maccasoft/propeller-vt100-terminal/(threads)

Thread 1 (2018-12-05):

full 9x16 support now available

konimaru, 2018-12-05:
Just to let you know that there is now a new version available which uses a real 9x16 font (liberated from some FON file). The colour blink attribute is currently MIA but can be brought back if necessary.

maccasoft, 2018-12-20:
Thank you, I have implemented the "nine" driver and I think I'm happy with it, even if it uses a bit more memory.

Happy holidays!

Closed 2018-12-20.

Thread 2 (2019-03-21):

question on build

huskeyw, 2019-03-21:
I built the code changing the pins for the usb keyboard and serial to match the hobytronics board.. I was hoping I could turn that into this card for use on a single board computer.
it builds and loads but then the screen goes to sleep.. I dont have a keyboard or even usb header connected..

this is the schematic for there board. not much different from what I can tell. if I am missing something do you mind letting me know. Thank you . PS I have never used a propeller processor before.. so I am guessing..

lines I changed
vt100.spin
  ' ser.StartRxTx(8, 9, 0, 115200) changed for hobytronics
  ' debug.StartRxTx(31, 30, 0, 115200) changed for hobytronics
   ser.StartRxTx(30, 31, 0, 115200)

and in USB_FS_HOST.spin

' modified for the Hobytronics serail_VGA from
  ' DMINUS = 1
  ' DPLUS = 0
  DMINUS = 3
  DPLUS = 4

link to their board

http://www.hobbytronics.co.uk/datasheets/serialvga-schematic-1-0.pdf

konimaru, 2019-03-21:
Your monitor shutting down is a bit suspicious. Can it handle 720x400?

maccasoft, 2019-03-21:
Aside from the monitor not supporting the resolution, I don't see other problems with that board. I suggest to upload the code without modifications and see if the monitor works (you should see only the cursor at the top-left corner as the screen will be blank at startup). You may also see LED2 flashing while the USB stack attempts to poll the device.

If you want to try the 640x400 resolution, remove the '.nine' word from the vga object line to pick up the old driver:

```
    'vga    : "waitvid.80x25.nine.driver" ' 720x400
    vga    : "waitvid.80x25.driver" ' 640x400
```

huskeyw, 2019-03-21:
Thank you. Did not expect a fast reply,

Good point, the monitor is an LCD Dell and so it may not like the
resolution, with it just going to sleep I figured no sign not thinking
comparable .. I dont have an CRT so I'll look at where I make that
change..  since I'm new ... I like your other card but the SBC I am working
on on my have serial and i2c.  Maybe If i learn enough .essing with this i
could get the other version to work with i2c ..  or maybe I'll add an
andrino between.  But that .ay be way too slow.

On Thu, Mar 21, 2019, 06:51 Marco Maccaferri <notifications@github.com>
wrote:

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

huskeyw, 2019-03-21:
tried with no changes.. .changed the resolution to use the 640x480, no video seen by the monitor. I reloaded the Hobytronics build and it comes right up. I wonder if the USB needs to see a  keyboard or some input (serial did not work not even debug.. )

I wonder if the USB needing an unconnected PIN, and its not in the schematic but if pin 2 is tied to ground, would that mess up the boot?

maccasoft, 2019-03-21:
The USB stack needs an unconnected pin for its internal syncrhonization, that is P2 defined as USBNC, from the Hobbytronic schematic there is nothing on P2 so that's not a problem. Anyway, that will affect the USB stack only, all other sections are independent. If you open vt100.spin you'll see the startup sequence from line 105, the VGA driver is started at line 126 after the initial setup so you should at least see a blank screen. I haven't asked but are you really sure that the monitor goes to sleep and it isn't just displaying a blank screen right ?

Also, from the debug serial port (the one connected to the prop-plug adapter pm P30/P31) you should see at least the 'USB Started' message, if you see nothing maybe something else is wrong here. If you are using propeller-load try with the following command:
```
propeller-load -p /dev/ttyUSB0 -e -r -t115200 vt100.binary
```
It should keep the terminal open and let you see the messages from the debug serial port.

Are you compiling / uploading vt100.spin right ? Not other files. Spin programs are not like other sources, they need a "root" source that calls all others, in this case is vt100.spin. If you attempt to compile and upload other files it won't work.

huskeyw, 2019-03-21:
So quick, it turns the monitor off, the power light goes yellow, its green
when on.

I am building and uploading will see if I can keep the port open, on the
hobbytronics board they reversed serial ports so you can plug a sparkfun or
adafruit ftdi in.

Will try, I'll take some pictures. I'm on monitor 4... this one is only VGA

Will put a logic probe on pin to to make sure its open

On Thu, Mar 21, 2019, 10:12 Marco Maccaferri <notifications@github.com>
wrote:

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

konimaru, 2019-03-21:
What's the exact model/make of the monitor you have?

huskeyw, 2019-03-22:
compiled with leaving the port open,
D:\propeller-vt100-terminal-master\propeller-vt100-terminal-master>propeller-load -p /com12 -e -r -t115200 vt100.binary
Propeller Version 1 on /com12
Loading vt100.binary to EEPROM via hub memory
23644 bytes sent
Verifying RAM ... OK
Programming EEPROM ... OK
Verifying EEPROM ... OK
[ Entering terminal mode. Type ESC or Control-C to exit. ]
^C
D:\propeller-vt100-terminal-master\propeller-vt100-terminal-master>openspin -b -u vt100.spin
Propeller Spin/PASM Compiler 'OpenSpin' (c)2012-2018 Parallax Inc. DBA Parallax Semiconductor.
Version 1.00.81 Compiled on Apr 27 2018 09:13:30
Compiling...
vt100.spin
|-usb-fs-host.spin
|-com.serial.spin
|-com.serial.terminal.spin
  |-com.serial.spin
  |-string.integer.spin
|-waitvid.80x25.nine.driver.spin
|-generic9x16-4font.spin
|-i2c.spin
|-keymap_it.spin
|-keymap_uk.spin
|-keymap_us.spin
|-keymap_fr.spin
|-keymap_de.spin
|-keymap_no.spin
Done.
Unused Method Elimination:
   73 methods removed
    1 objects removed
 1788 bytes saved
--------------------------
Program size is 23644 bytes

D:\propeller-vt100-terminal-master\propeller-vt100-terminal-master>propeller-load -p /com12 -e -r -t115200 vt100.binary
Propeller Version 1 on /com12
Loading vt100.binary to EEPROM via hub memory
23644 bytes sent
Verifying RAM ... OK
Programming EEPROM ... OK
Verifying EEPROM ... OK
[ Entering terminal mode. Type ESC or Control-C to exit. ]

no output from the serial port..

my monitors
dell us2410
dell e151fpb

konimaru, 2019-03-22:
re: serial, I noticed you swapped the pins (31/30) in your first post. Was that on purpose?

konimaru, 2019-03-22:
Odd, both monitors should be able to handle 720x400@70Hz.

huskeyw, 2019-03-22:
It's how the board is wired from hobbytronics.. I did it both ways..
intresting that no matter where I put serial the propeller will let it be
reprogramed,

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

huskeyw, 2019-03-22:
Well, I need to grab the oscope and logic probe.. I added some debug and it
does not print that either.. so something on the board is causing it to not
boot..  lole I said, I would send you the board and see what you think, you
could keep it, I'll get another.

I do appreciate the help, I'll send you one of the mcb2 boards I'm using as
well, dont have the cmos z80 but I can throw in the amtel amtel and memory
as a thank you

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

maccasoft, 2019-03-23:
Out of curiosity, I have uploaded the serialVGA firmware to one of my boards and it works, without changes.

If you want to try one last thing, the following is the bare minimun code needed to start the vga driver:

```
PUB start | temp

    wordfill(@scrn, $41_70, scrn_bcnt)
    cursor.byte[CX] := 0
    cursor.byte[CY] := 0
    cursor.byte{CM} := (cursor.byte{CM} & constant(!CURSOR_MASK)) | CURSOR_ON | constant(CURSOR_ULINE | CURSOR_FLASH)

    link{0} := video | @scrn{0}
    link[1] := font.addr
    link[2] := @cursor
    vga.init(-1, @link{0})
```

Replace the init method (or rename the existing to init2 and add the above before it, must be the first method in the source), compile and upload. Make sure to keep indentation and the like, spin source depends on indentation like Python, one row not aligned correctly and the program may not work as expected.

konimaru, 2019-03-25:
For the record, I just tried the built-in demos for [C0DF](https://github.com/konimaru/waitvid.2048/tree/master/80x25%20RAM/C0DF/src) and [NINE](https://github.com/konimaru/waitvid.2048/tree/master/80x25%20RAM/NINE/src) on a Dell U2412M (at work) and I do get a perfectly normal VGA image (720x400@70).

huskeyw, 2019-03-25:
I am sure it's this board, or something I screwed up. Have not had time to
get back to it, thanks for the support

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

konimaru, 2019-03-26:
Had a closer look at the schematic last night, is it just me or aren't there **any** decoupling capacitors at all? No wonder this board freaks out with odd loads.

huskeyw, 2019-03-27:
I only see two capacitors on the board..  I took a logic probe and with
their code I get lots of activity on the vga pins, but with yours its a all
lows.. something on this board is stopping your code from running.. not
sure what it is.. but like I said, Ill send you this board if you want to
hack on it.. no real reason but curiosity, but the offer is still there.

William "Steve" Huskey
Managing Member Dreadnought Brewing LLC

On Tue, Mar 26, 2019 at 12:37 AM Marko Lukat <notifications@github.com>
wrote:

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

huskeyw, 2019-03-27:
as an added note, I just built your code, no changes, just unzip build and
load, and it does not boot the chip.. does propeller have a debugger IDE?
Really wasting too much time on this, curiosity on what they did to make it
not work with other code..

On Sat, Mar 23, 2019, 05:55 Marco Maccaferri <notifications@github.com>
wrote:

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

konimaru, 2019-03-27:
>.. but like I said, Ill send you this board if you want to hack on it.. no real reason but curiosity, but the offer is still there. William "Steve" Huskey Managing Member Dreadnought Brewing LLC

OK, oddly enough I'd like to see this one through :) Do you have an email I can send my details to?

huskeyw, 2019-03-27:
William.huskey@gmail.com

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

konimaru, 2019-05-09:
Progress so far (programming done with PropPlug):
- I decided to wire BOE to GND (was floating)
- anything I could throw at it just worked (specifically video stuff)

huskeyw, 2019-05-09:
so once you grounded it that pin it worked?

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

konimaru, 2019-05-09:
It worked before as well, just programming the chip was a bit hit and miss.

I'm a bit puzzled by this. While I still think they should have added decoupling Cs there seems to be nothing wrong with it otherwise. How exactly did you program this thing (RAM/EEPROM, type of cable)? I recall you saying that the original firmware worked but other stuff did not so it can't really be the way it was programmed ...

cbmeeks, 2019-05-09:
I've built many Prop video circuits on breadboards and have only put caps near power pins.  But that BOE pin should always be grounded.  Perhaps it can sometimes float with no issues but I suggest grounding.  If you look at the Propeller reference guide, you will see it's grounded.

Probably an oversight on that hobby board.

huskeyw, 2019-05-09:
I used a propeller prop and the command line tool, not sure how I could get
that wrong.. but maybe I had something wrong..

my finial goal was to get the your terminal on there as a start,  but I
wanted to see if I can get your other video card as i2c and use it in a i2c
connection to provide a "real" video card for that single board system I
sent you.. I am  kind of miffed why I could not program it.. while I have
never used a propeller before, I had not issue reloading it..

William "Steve" Huskey
Managing Member Dreadnought Brewing LLC

On Thu, May 9, 2019 at 12:09 PM Marko Lukat <notifications@github.com>
wrote:

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

Thread 3 (2019-10-31):

SALUTI ! Question about changing default text color

MorfeoMatrixx, 2019-10-31:
Hi Marco ! Congrats for your excellent work! Really enjoying your Terminal with an SC126 RC2014 board. Only one question, how do I change the source code in vt100.spin to set a different color for the Foreground attribute ? I successfully changed the CTRL-F10 setup screen to green using $20 and $A0 instead of $70 and $F0 for text attributes, but didn´t find where to change the default color for the terminal text and cursor.

I´ll really appreciate if you can point me to the correct section of the code so I can make the change.
Thanks in advance.

Regards,
Jose Luis.

maccasoft, 2019-10-31:
The text color is defined in the txt_attr variable at line 363. It is reset with the ANSI escape sequence at line 564, you need to change that too if your application uses ANSI color sequences.
The screen is initially filled with the default color at line 110 (first byte is character, second is attribute).
The cursor color follows the attribute at the cursor position, so if you fill the screen with green on black the cursor is also green.

MorfeoMatrixx, 2019-10-31:
Many thanks Marco for your fast response, I'll try it when I get home this
afternoon. I managed to define and set as default a new layout for the
Spanish (Latin American variant) keyboard, and I'm also investigating how
to add an option to the config menu to change the serial port Baudrate. I
think an option for setting the default text color could be added too.

If I succeed I'll let you know in case you want to add this features to
your code. I'll be glad to collaborate with your project, but my
knowledge on the spin language is very basic, but I'm learning.

Grazie e saluti ! (by the way, my wife is Italian ;-)
José Luis.

On Thu, Oct 31, 2019 at 9:37 AM Marco Maccaferri <notifications@github.com>
wrote:

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

maccasoft, 2019-11-01:
I have a patch that adds the baud rate settings, if you want to try it. I'm not sure to add this option, there isn't much memory left (with another keyboard map there is even less available) and the only issue is with the Z180 / RomWBW variant that defaults to 38400. It is very easy to set the speed to 115200, rebuild the binary image and flash the rom.

MorfeoMatrixx, 2019-11-01:
Marco, with your help I was able to change the default colors, and I'm
adding an option in the Settings Screen for this !
I'll appreciate if you could share the patch for baud-rate selection, since
I can add it after deleting unused keyboard maps.

IMHO, regarding the keyboard selection code, once you have it working with
your hardware, you don´t need it anymore. Maybe leaving only 2 options is
enough, providing some short instructions on how to cut & paste the correct
mapping file for the first compile.

Instead, the baud-rate selection functionality could be used more
frequently, as you mention if one switches between SCM and ROMWBW in the
SC126 Z180 board. Also the potential of your board been used as a
stand-alone VT-100 with any retro-computer is huge, specially because it's
the only option I know for using USB keyboards.

Grazie e Saluti,
JL.

On Fri, Nov 1, 2019 at 6:43 AM Marco Maccaferri <notifications@github.com>
wrote:

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

MorfeoMatrixx, 2019-11-26:
Hi Marco, everything went OK with my changes to the Settings screen, I can change the baudrate "live" but the color is still fixed (I can only change it recompiling), because **I am incompetent with propeller machine language** and I can´t figure out in your code how to pass a variable that is in Hub memory (VAR section) containing the new desired attribute (color) to the **txt_attr** variable in the machine code segment in the DAT section...

I looked thru some book examples but failed with RDBYTE, PAR, etc...
I'll really appreciate if you can guide me with this part so I can finish my modification and share it.

Thanks and regards, JL.

maccasoft, 2019-11-28:
>  I can´t figure out in your code how to pass a variable that is in Hub memory (VAR section) containing the new desired attribute (color) to the **txt_attr** variable in the machine code segment in the DAT section...

Simply, you can't. The txt_attr variable is initialized when the terminal cog is started, then it is managed from within the cog and doesn't interact with the hub memory anymore.You can stop and restart the terminal cog to reinitialize the txt_attr value, however this also resets the terminal status so anything on screen will be out of sync. You'll need to save the cog id at vt100.spin:183 to issue the new coginit.

MorfeoMatrixx, 2019-11-28:
Thanks a lot Marco ! I´ll try this approach, I feel I am so close to
success... In the meantime I've learn a lot of the Propeller architecture
(this is why I decided to modify your code); it´s a pity it hasn't got a
wider user base. It´s a chip with a strong and weird "personality".

Saludos,
José Luis.

On Thu, Nov 28, 2019 at 7:19 AM Marco Maccaferri <notifications@github.com>
wrote:

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

MorfeoMatrixx, 2019-12-21:
I finally got everything working usin the PAR register and RDBYTE. I can now change the terminal foreground and background colors at will, and baud-rate also. When I detect a change in FG or BG colors, I simply issue the spin REBOOT method, so everything gets in-sync again. The serial connection get's restarted but it's fast enough that doesn't affect the HOST system.

Thanks Marco for all your support, I'm very happy with my mod to the code; I can share it if you like.

Cheers, JL.

Thread 4 (2020-05-25):

Build issue: Object exceeds runtime memory limit by 59 longs.

thedrip, 2020-05-25:
When building the project using the default .spin files and latest (1.00.78 2016) version of OpenSpin I receive the following error,

F:\Documents\6502\vt100>**openspin -b -u vt100.spin**
Propeller Spin/PASM Compiler 'OpenSpin' (c)2012-2016 Parallax Inc. DBA Parallax Semiconductor.
Version 1.00.78 Compiled on Jan 16 2016 15:37:47
Compiling...
vt100.spin
|-usb-fs-host.spin
|-com.serial.spin
|-waitvid.80x25.nine.driver.spin
|-generic9x16-4font.spin
|-keyboard.spin
|-i2c.spin
**vt100.spin : error : Object exceeds runtime memory limit by 59 longs.**

thedrip, 2020-05-25:
I was able to correct this issue by adding -M 65536 to the command line.

Openspin performs the -u optimization after the memory limit checks.

By forced the maximum size to be 64K instead 32K, the code passes the memory limit checks and then is optimized below the 32K limitation of the serial EEPROM.

I know it's not usual to open and close your own issue so quickly, I wanted to share in case future users have the same issue.

F:\Documents\6502\vt100>**openspin -b -u -M 65536 vt100.spin**
Propeller Spin/PASM Compiler 'OpenSpin' (c)2012-2016 Parallax Inc. DBA Parallax Semiconductor.
Version 1.00.78 Compiled on Jan 16 2016 15:37:47
Compiling...
vt100.spin
|-usb-fs-host.spin
|-com.serial.spin
|-waitvid.80x25.nine.driver.spin
|-generic9x16-4font.spin
|-keyboard.spin
|-i2c.spin
Done.
|-usb-fs-host.spin
|-com.serial.spin
|-waitvid.80x25.nine.driver.spin
|-generic9x16-4font.spin
|-keyboard.spin
|-i2c.spin
Done.
**Program size is 23224 bytes**

thedrip, 2020-05-26:
Apparently I dont know how Github works, re-opening issue so others can see it!

maccasoft, 2020-05-26:
I'm using the most recent version 1.00.81 compiled from sources, available from my web site https://www.maccasoft.com/downloads/

thedrip, 2020-05-27:
1.00.81 works a treat, too bad they had an old version for download on the official site.

Thank you

Thread 5 (2020-05-26):

More standard VGA modes

thedrip, 2020-05-26:
Is it possible to implement a more standard VGA mode like 640x480@60.

For testing purposes really, I have two monitors that aren't supporting either mode. Oscilloscope readings of the vertical and horizontal sync look correct for both resolutions, as does the dot clock on the color lines.

I'm out of Monitors to try!

Thanks

konimaru, 2020-05-26:
https://github.com/konimaru/waitvid.2048/tree/master/480p

thedrip, 2020-05-30:
It worked great. My issue was that I re-spun the board from schematics and got Hsync and vsync backwards.

Works great, including in the 640x480 and 720x480 modes!

Thread 7 (2021-08-17):

Strange crash when paging down a particular file in a text editor

jes, 2021-08-17:
I'm using an RC2014 VGA Serial Console in a homemade CPU, and I am encountering a strange crash when trying to edit a particular text file. Here's a video demonstrating the problem: https://www.youtube.com/watch?v=OKDQznJkS2M

This happens reliably every single time I try to page down this file by 2 pages. Steps to reproduce (although nobody but me has this computer) are:

1. open hamurabi.sl in kilo (it only works for hamurabi.sl, and it only works in the text editor - catting it to the screen doesn't cause any problem - I haven't yet investigated what specifically about this source file is causing the problem).
2. scroll down twice (Ctrl-D, Ctrl-D)
3. the VGA console will crash, and the screen will probably turn off (occasionally it shows a green-and-yellow pattern instead of turning off).

I wonder how we would go about debugging this? I think a first step would be to capture the exact bytes that are transmitted and replay them using a USB serial cable and see if it still crashes it - that would rule out some hardware-specific timing problem and would allow others to reproduce the problem. I'll work on doing that.

jes, 2021-08-17:
This happens on both the RC2014-compatible board and on a standalone one that I don't think you sell any more, that I bought online from a chap in Gibraltar, which I think rules out any possibility that I have a faulty board.

jes, 2021-08-17:
From watching the video back frame-by-frame it appears to get stuck on the first line in the file that is more than 80 characters wide (it's 81), which seems like it could be a good clue. The editor is meant to stop the line at 80, but even if it doesn't I don't think the terminal should crash every time it has to line wrap.

jes, 2021-08-17:
In this file: https://github.com/maccasoft/propeller-vt100-terminal/issues/7

For "other" it only writes into `byte[line][size]` if `size < maxline`, but for `NL,LF` it can write to `bvte[line][size]` even if `size == maxline`. This seems like it could be the problem. I think my editor is writing a newline 1 character past the end of the line, which is causing a buffer overflow in the terminal?

jes, 2021-08-17:
I tried making a new file and typing a line that is as wide as the screen and it caused the terminal to crash, so I'm pretty sure this is the problem, but I don't quite see why overflowing the line is a serious error rather than just overwriting the start of the next line.

I'm also surprised that this has never been observed before - I wonder if my editor also has an off-by-1 error which is triggering this bug in a way that most wouldn't.

jes, 2021-08-17:
I can't actually find anything that calls `ReadLine`, so maybe that is unused vestigial code and isn't the source of the problem after all?

maccasoft, 2021-08-17:
The terminal firmware doesn't provide any editing capability, it only decodes the ANSI escape codes.
My guess is that the editor sends a code that is not interpreted correctly by the firmware causing a write to a location outside the screen buffer. Since it is reproducible, can you attach the minmal files needed ? I think the kilo editor executable and the source file you are editing ? I'll try to reproduce here and capture the code stream to see if there are weird escape codes.

jes, 2021-08-17:
I don't think the executable will be much use to you - this isn't a Z80 machine, it's a completely homebrew CPU design.

I've attached a capture of the bytes output in a session booting up, starting the editor, and paging down 3 times.

I believe the line "IN YEAR %u, %u PEOPLE STARVED, %u CAME TO THE CITY" is the one that crashes the terminal.

jes, 2021-08-17:
I deleted all of the lines apart from "IN YEAR %u" and cat'd it to the VGA Serial PCB via an FTDI cable, and it still crashes. It does *not* crash if I delete the "ESC [ K" at the end of the line.

So I'd say the problem seems to be caused by an "ESC [ K" (clear to end of line) while the cursor is already at the end of the line.

jes, 2021-08-17:
I think the implementation of "ESC [ K" is here: https://github.com/maccasoft/propeller-vt100-terminal/blob/master/vt100.spin#L1178 but I'm not smart enough to see if there's an obvious error.

jes, 2021-08-17:
I think the problem is in el0: t3 gets set to `#scrn_columns - x`, and then there is `djnz t3`, but if `x == #scrn_columns` then this will decrement x to - 1 and then overwrite almost all of memory.

It's not quite as simple as that because there are some `-2`s lying around, but I think it's roughly that?

maccasoft, 2021-08-18:
Good catch, the problem was that. I have added the zero check and now it should work correctly.
I'm attaching the updated binary, please check if it works for you, then I'll update the source.

If you want to test with a terminal program, the sequence `ESC[1;80H-ESC[K` should trigger the crash.

[rc2014_terminal_720x400_usb.zip](https://github.com/maccasoft/propeller-vt100-terminal/files/7005699/rc2014_terminal_720x400_usb.zip)

jes, 2021-08-18:
Thanks! I've never written a binary to this before and don't have a Prop-Plug, but I'm going to follow these instructions for writing to the EEPROM: http://www.learningaboutelectronics.com/Articles/24LC256-EEPROM-circuit-with-an-arduino.php and hopefully I'll succeed.

jes, 2021-08-18:
Perfect, that did the trick, thanks again!

jes, 2021-08-18:
I'd be keen to see the source as I'd like to apply it to https://github.com/MorfeoMatrixx/propeller-vt100-terminal/ which adds dynamic baud rate selection.

jes, 2021-08-19:
Great stuff, thanks Marco! :+1:

Closed 2021-08-19.
