maccasoft/propeller-vt100-terminal/(commit log)

2017-10-29 Initial README and board image
2017-10-30 Added LEDs control
2017-11-01 Added prototype design files and updated README
2017-11-06 Added conditional compile to set 640x400@70Hz or 720x400@70Hz VGA modes
2017-12-08 Added piezo speaker driver for BEL (7) character
2017-12-09 Updated board to revision 1
2017-12-09 Updated board image
2017-12-11 Wait for RX line to be ready before starting the serial driver
2018-01-04 Added schematic image
2018-01-04 Added schematic image and fixed parts list
2018-04-20 Added reverse attribute and ESC character print
2018-05-11 Implemented line delete and insert terminal codes
2018-11-18 Added I2C driver
2018-12-11 Added new video driver with 720x400 resolution and full 9x16 font
2018-12-14 Fixed video driver objects
2019-09-16 Implemented start bit detection noise filter
2020-05-18 Implemented device status report
2020-08-27 Font moved to video driver
2021-08-07 Fixed case sensitive identifiers
    [i2c.spin]
